vinthewrench/garden-I2C-board/Photo.jpg

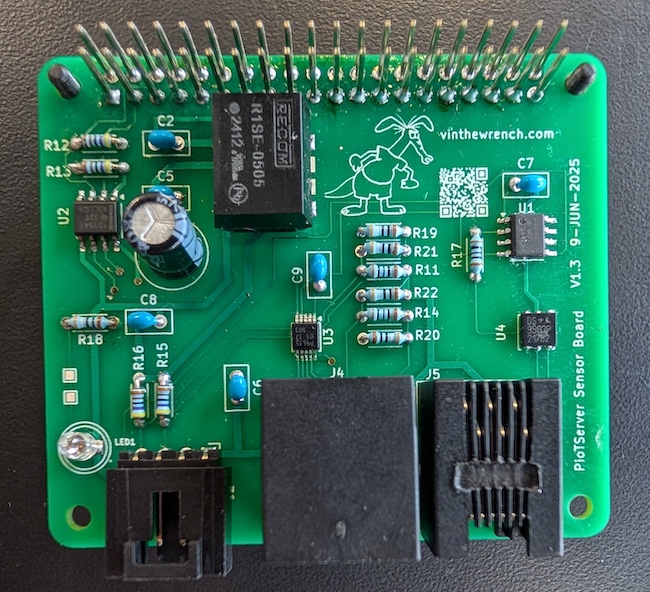
Photo.jpg
