vinthewrench/garden-I2C-board/README.md

Raspberry Pi add on card to that provides isolated I2C, Differential I2C and 1-Wire support.

see the article at https://www.vinthewrench.com/p/raspberry-pi-internet-of-things-part-2a8
