vinthewrench/garden-I2C-board/3D.png

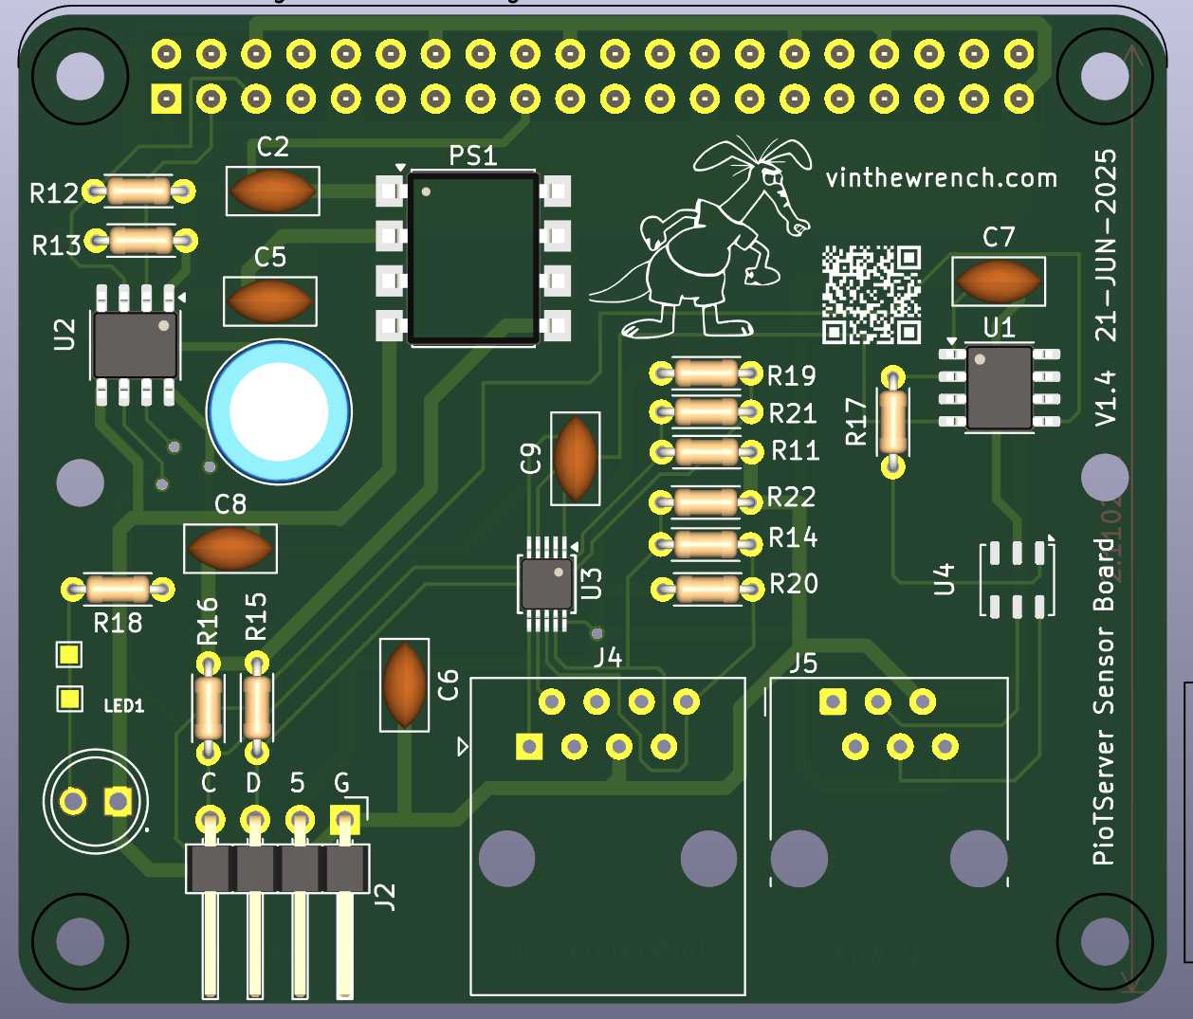
3D.png
