vinthewrench/garden-I2C-board/Schematic.pdf

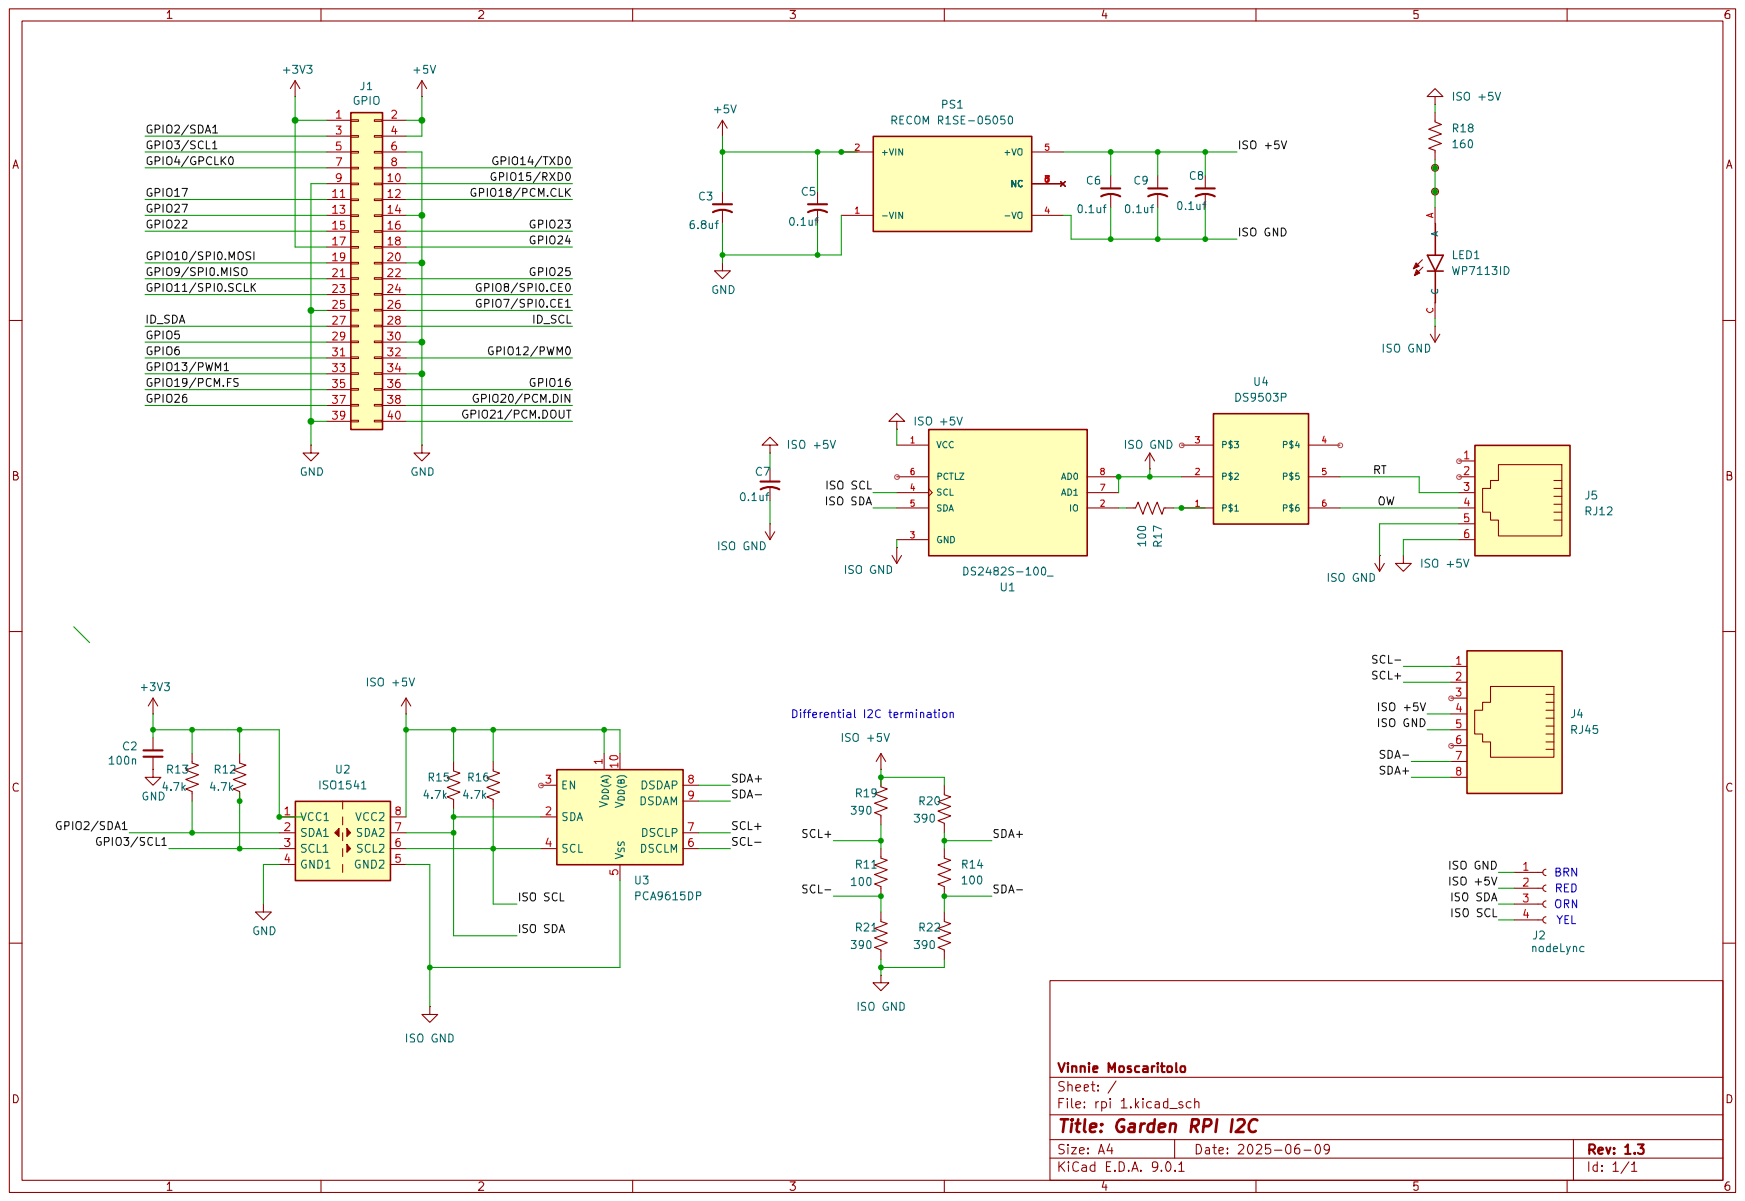
[picture p3: page 1]
