vinthewrench/garden-I2C-board/src/rpi 1.kicad_pcb

## KiCad design src/rpi 1.kicad_pcb (2025-06-21)

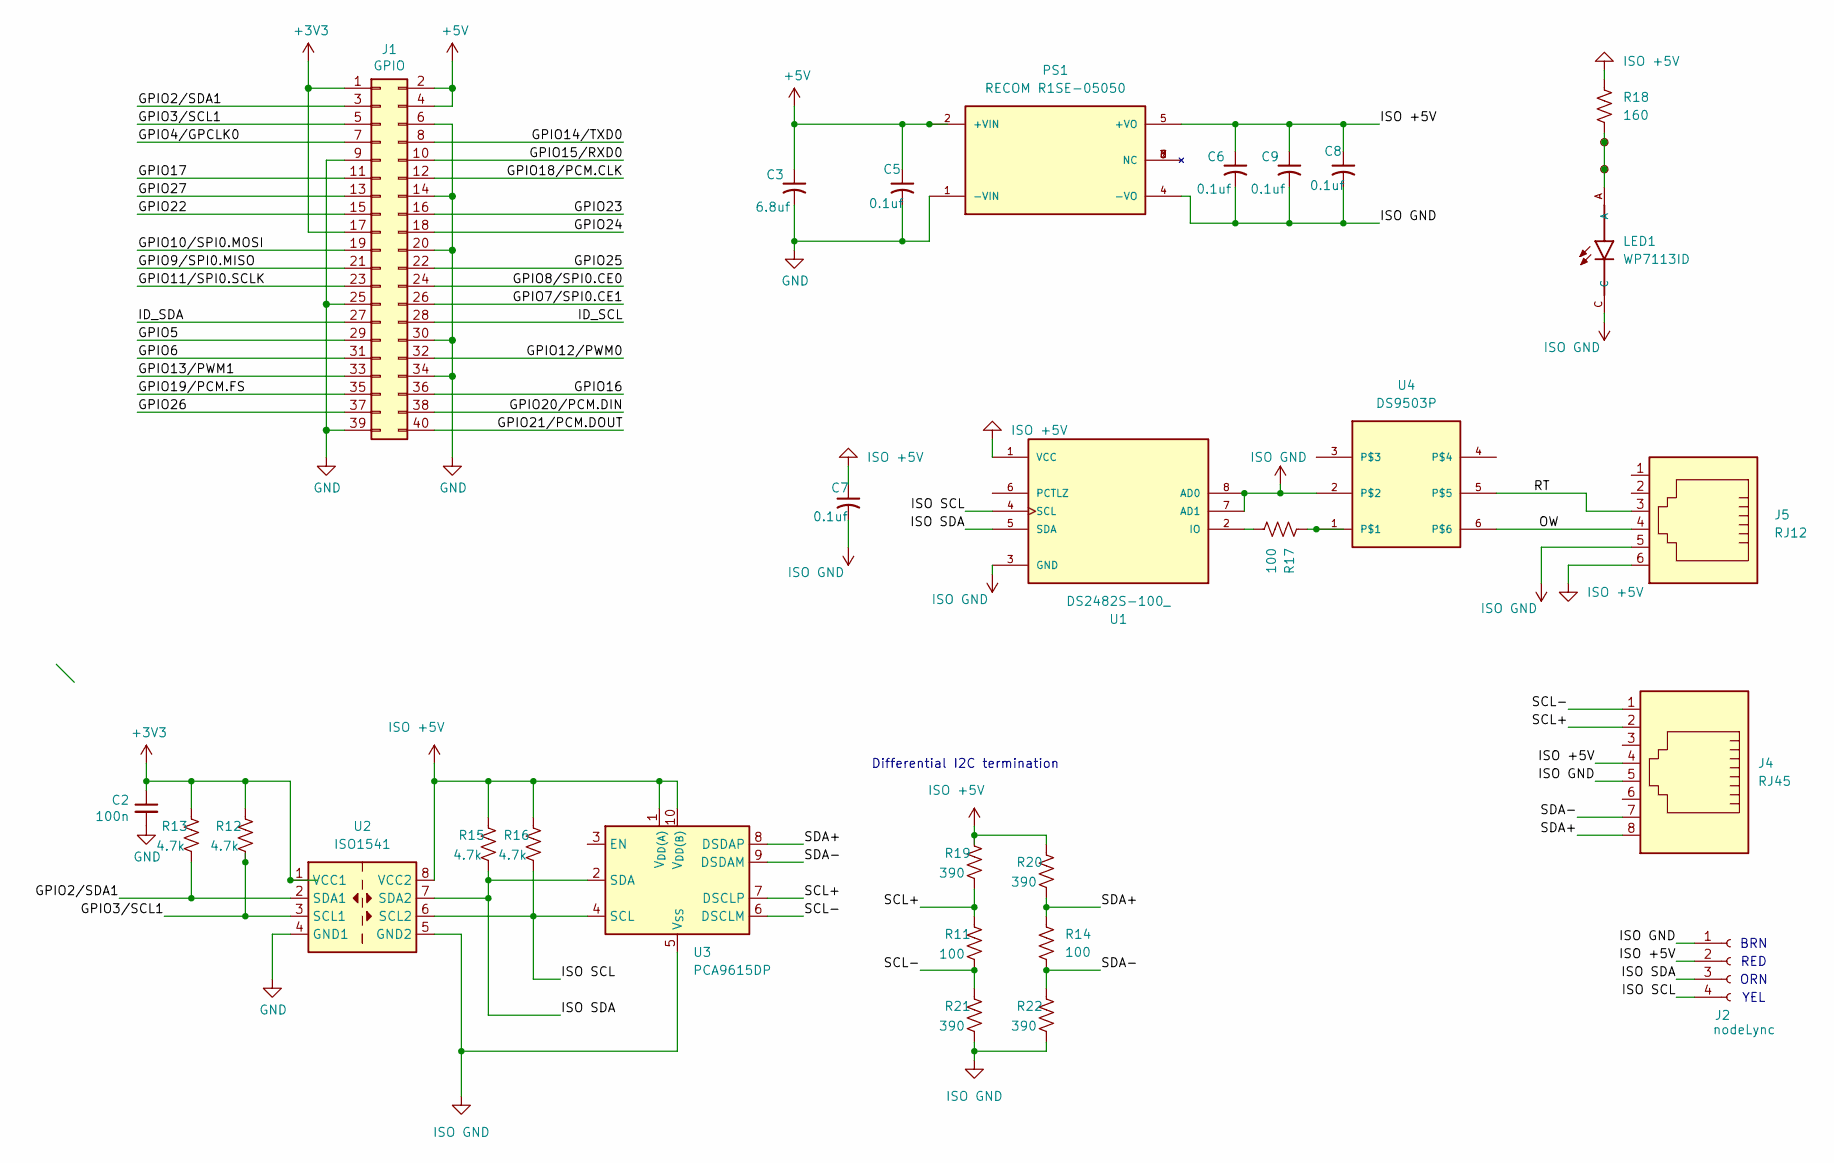
[picture p4: schematic rpi 1.kicad_sch, Garden RPI I2C]

Parts:
C2: 100n; C_Disc_D5.0mm_W2.5mm_P2.50mm
C3: 6.8uf; C_Radial_D8.0mm_H11.5mm_P3.50mm
C5, C6, C7, C8, C9: 0.1uf; C_Disc_D5.0mm_W2.5mm_P2.50mm
J1: GPIO; PinSocket_2x20_P2.54mm_Vertical
J2: nodeLync; PinHeader_1x04_P2.54mm_Horizontal
J4: RJ45; RJ45_Amphenol_54602-x08_Horizontal
J5: RJ12; RJ12_Amphenol_54601-x06_Horizontal
LED1: WP7113ID; LED_WP7113ID
PS1: RECOM R1SE-05050; SSO-8_6.7x9.8mm_P2.54mm_Clearance8mm; PARTREV September 23, 2022
R11, R14, R17: 100; R_Axial_DIN0204_L3.6mm_D1.6mm_P5.08mm_Horizontal
R12, R13, R15, R16: 4.7k; R_Axial_DIN0204_L3.6mm_D1.6mm_P5.08mm_Horizontal
R18: 160; R_Axial_DIN0204_L3.6mm_D1.6mm_P5.08mm_Horizontal
R19, R20, R21, R22: 390; R_Axial_DIN0204_L3.6mm_D1.6mm_P5.08mm_Horizontal
TP1, TP2: TestPoint_Small; TestPoint_Pad_1.0x1.0mm
U1: DS2482S-100_; SOIC-8_3.9x4.9mm_P1.27mm
U2: ISO1541; SOIC-8_3.9x4.9mm_P1.27mm
U3: PCA9615DP; TSSOP-10_3x3mm_P0.5mm
U4: DS9503P; TSOC-6_3.76x3.94mm_P1.27mm

Connections:
+3V3: C2.1, J1.1, J1.17, R12.1, R13.1, U2.1 (VCC1)
+5V: C3.1, C5.1, J1.2, J1.4, PS1.2 (+VIN)
/GPIO2/SDA1: J1.3, R13.2, U2.2 (SDA1)
/GPIO3/SCL1: J1.5, R12.2, U2.3 (SCL1)
/GPIO4/GPCLK0: J1.7
/GPIO5: J1.29
/GPIO6: J1.31
/GPIO7/SPI0.CE1: J1.26
/GPIO8/SPI0.CE0: J1.24
/GPIO9/SPI0.MISO: J1.21
/GPIO10/SPI0.MOSI: J1.19
/GPIO11/SPI0.SCLK: J1.23
/GPIO12/PWM0: J1.32
/GPIO13/PWM1: J1.33
/GPIO14/TXD0: J1.8
/GPIO15/RXD0: J1.10
/GPIO16: J1.36
/GPIO17: J1.11
/GPIO18/PCM.CLK: J1.12
/GPIO19/PCM.FS: J1.35
/GPIO20/PCM.DIN: J1.38
/GPIO21/PCM.DOUT: J1.40
/GPIO22: J1.15
/GPIO23: J1.16
/GPIO24: J1.18
/GPIO25: J1.22
/GPIO26: J1.37
/GPIO27: J1.13
/ID_SCL: J1.28
/ID_SDA: J1.27
/ISO SCL: J2.4, R16.2, U1.4 (SCL), U2.6 (SCL2), U3.4 (SCL)
/ISO SDA: J2.3, R15.2, U1.5 (SDA), U2.7 (SDA2), U3.2 (SDA)
/OW: J5.4, U4.6
/RT: J5.3, U4.5
/SCL+: J4.2, R11.1, R19.2, U3.7 (DSCLP)
/SCL-: J4.1, R11.2, R21.1, U3.6 (DSCLM)
/SDA+: J4.8, R14.1, R20.2, U3.8 (DSDAP)
/SDA-: J4.7, R14.2, R22.1, U3.9 (DSDAM)
GND: C2.2, C3.2, C5.2, J1.6, J1.9, J1.14, J1.20, J1.25, J1.30, J1.34, J1.39, PS1.1 (-VIN), U2.4 (GND1)
ISO +5V: C6.1, C7.1, C8.1, C9.1, J2.2, J4.4, J5.6, PS1.5 (+VO), R15.1, R16.1, R18.1, R19.1, R20.1, U1.1 (VCC), U2.8 (VCC2), U3.1 (V_{DD(A)}), U3.10 (V_{DD(B)})
ISO GND: C6.2, C7.2, C8.2, C9.2, J2.1, J4.5, J5.5, LED1.C, PS1.4 (-VO), R21.2, R22.2, U1.3 (GND), U1.7 (AD1), U1.8 (AD0), U2.5 (GND2), U3.5 (V_{SS}), U4.2
unnamed: LED1.A, R18.2, TP1.1, TP2.1
unnamed: R17.2, U1.2 (IO)
unnamed: R17.1, U4.1

Notes on the sheet:
BRN
Differential I2C termination
YEL
RED
ORN

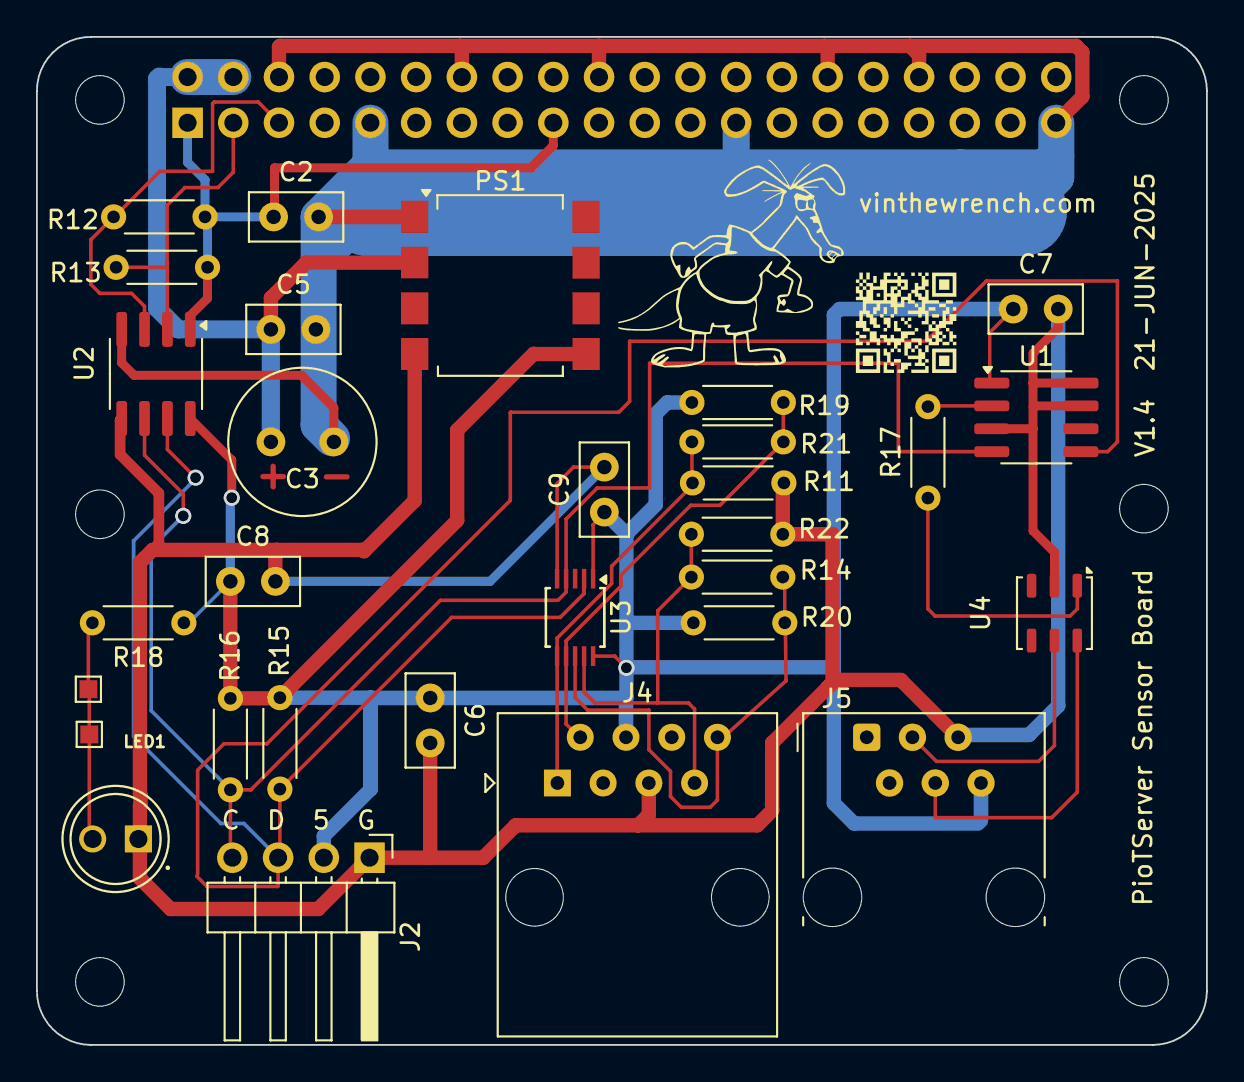
[picture p5: board rpi 1.kicad_pcb from above]

Board: 2 copper layers, 65.0 x 56.0 mm, 36 parts (1 on the bottom side), 18 nets.

Other parts of the board:
MH1, MH2, MH3, MH4: MountingHole_2.7mm_M2.5
X: LOGO; aard1
