vinthewrench/garden-I2C-board/(commit log)

2025-06-21 first checkin
    [rpi 1-B_Cu.gbl, rpi 1-B_Mask.gbs, rpi 1-B_Silkscreen.gbo, rpi 1-F_Cu.gtl, rpi 1-F_Mask.gts, rpi 1-F_Silkscreen.gto, rpi 1-Margin.gbr, rpi 1-NPTH-drl_map.gbr]
2025-06-21 add schematic pdf
